teapotlaboratories/petb1a/hardware/kicad/petb1a.kicad_pcb

## KiCad design hardware/kicad/petb1a.kicad_pcb (2024-02-28)

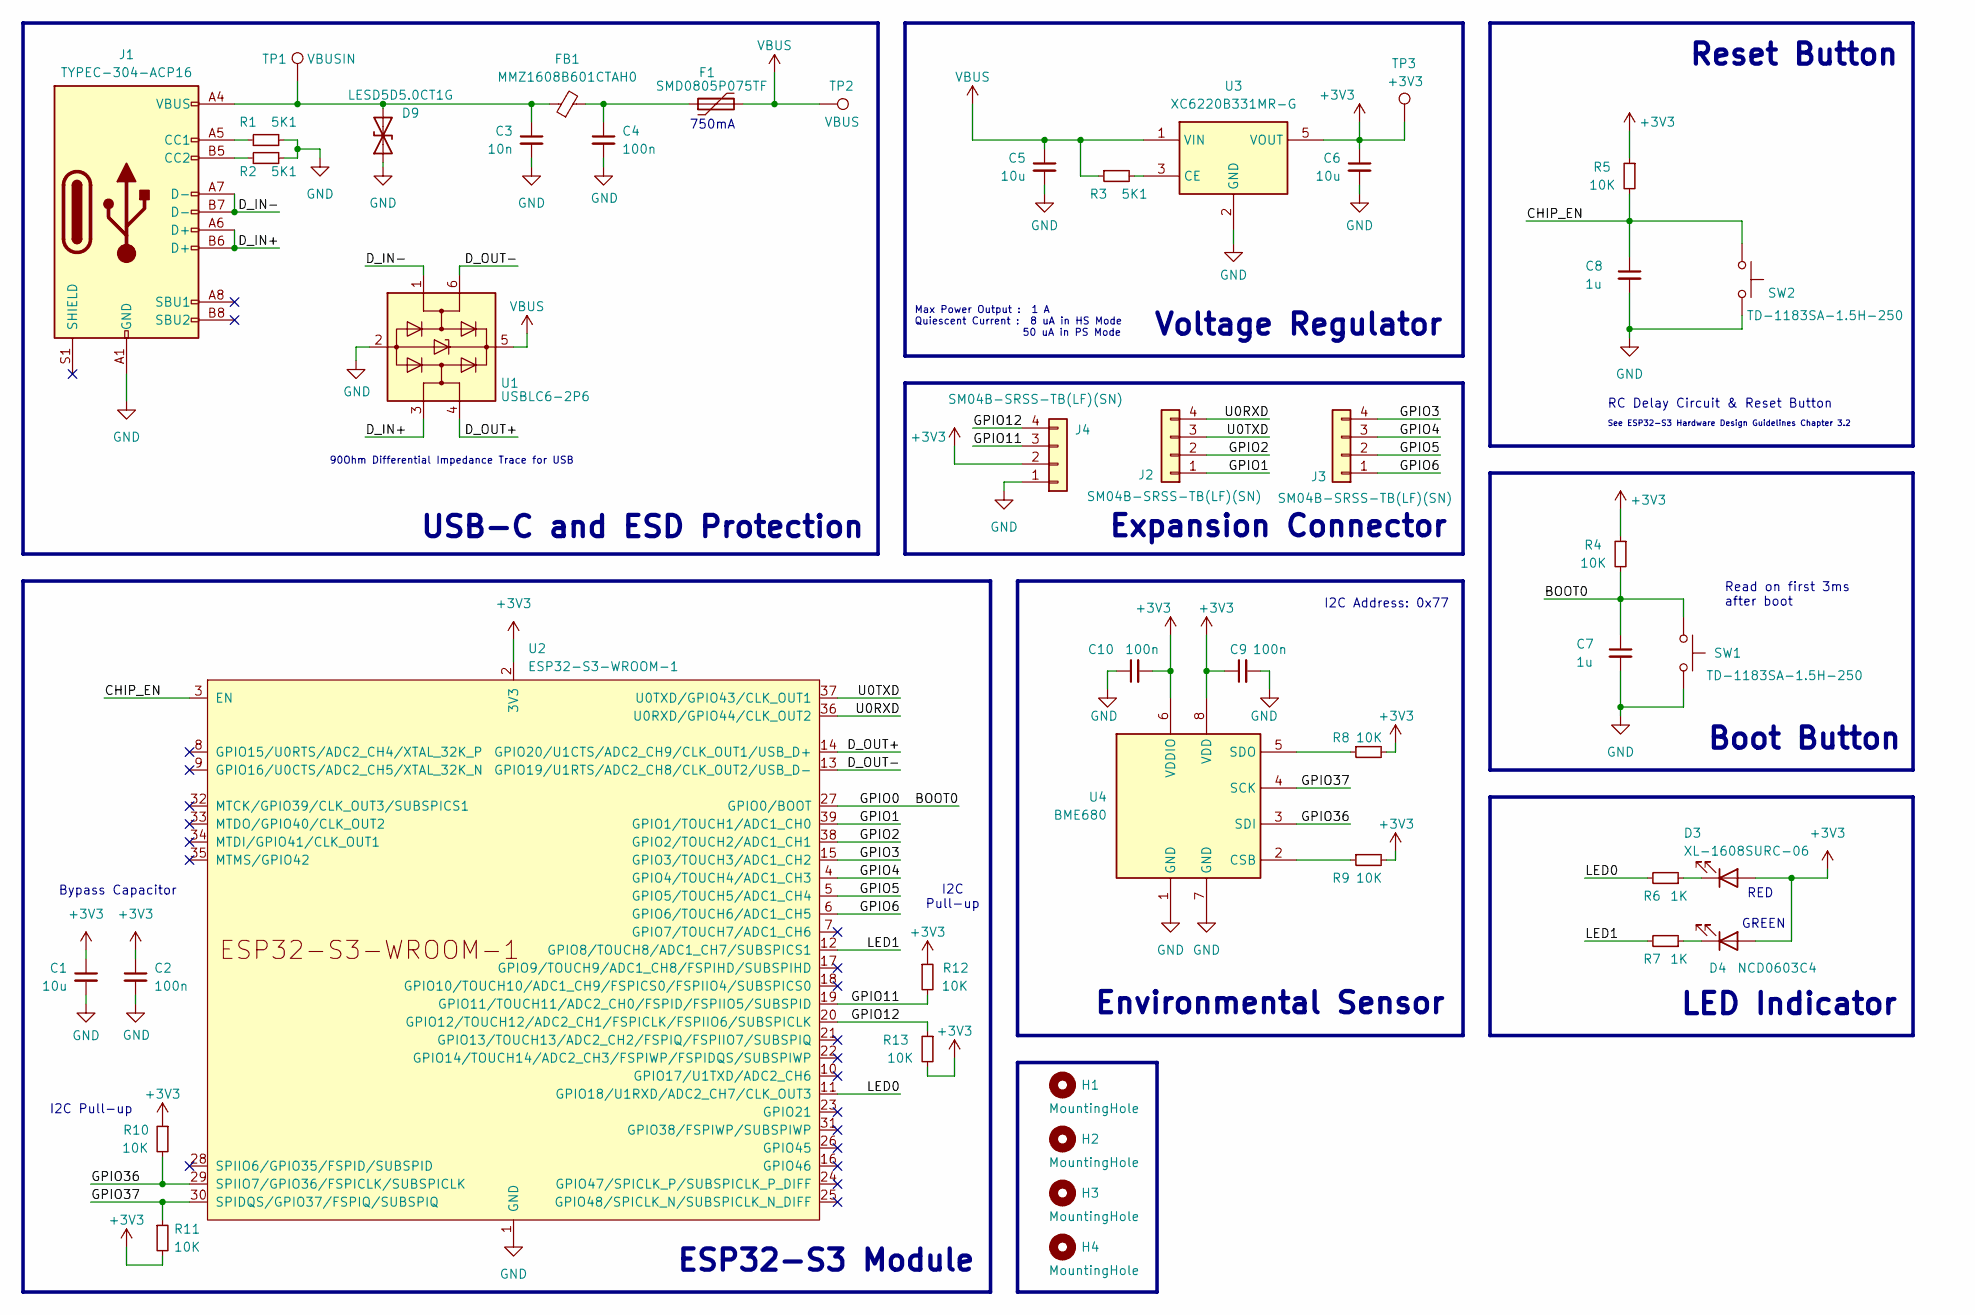
[picture p1: schematic petb1a.kicad_sch, Teapotlabs PETB1A]

Parts:
C1, C5, C6: 10u; C_0603_1608Metric; Manufacturer Part Number CL10A106KP8NNNC
C2, C4: 100n; C_0603_1608Metric; Manufacturer Part Number CL10B104KB8NNNC
C3: 10n; C_0603_1608Metric; Manufacturer Part Number CC0603KRX7R9BB103
C7, C8: 1u; C_0402_1005Metric; Manufacturer Part Number GRM155Z71A105KE01D
C9, C10: 100n; C_0402_1005Metric; Manufacturer Part Number GRM155R71H104KE14D
D3: XL-1608SURC-06; LED_0603_1608Metric; Manufacturer Part Number XL-1608SURC-06
D4: NCD0603C4; LED_0603_1608Metric; Manufacturer Part Number NCD0603C4
D9: LESD5D5.0CT1G; D_SOD-523; Manufacturer Part Number LESD5D5.0CT1G
F1: SMD0805P075TF; Fuse_0805_2012Metric; Manufacturer Part Number SMD0805P075TF
FB1: MMZ1608B601CTAH0; L_0603_1608Metric; Manufacturer Part Number MMZ1608B601CTAH0
H1, H2, H3, H4: MountingHole; MountingHole_3.2mm_M3
J1: TYPEC-304-ACP16; USB-C-SMD_TYPE-C-16P-1; Manufacturer Part Number TYPEC-304-ACP16
J2, J3, J4: SM04B-SRSS-TB(LF)(SN); JST_SH_SM04B-SRSS-TB_1x04-1MP_P1.00mm_Horizontal; Manufacturer Part Number SM04B-SRSS-TB(LF)(SN)
R1, R2, R3: 5K1; R_0402_1005Metric; Manufacturer Part Number 0402WGF5101TCE
R4, R5, R8, R9, R10, R11, R12, R13: 10K; R_0402_1005Metric; Manufacturer Part Number 0402WGF1002TCE
R6, R7: 1K; R_0603_1608Metric; Manufacturer Part Number RC0603FR-071KL
SW1, SW2: TD-1183SA-1.5H-250; KEY-SMD_L3.0-W2.5-LS4.0; Manufacturer Part Number TD-1183SA-1.5H-250
TP1: VBUSIN; TestPoint_Pad_D1.0mm
TP2: VBUS; TestPoint_Pad_D1.0mm
TP3: +3V3; TestPoint_Pad_D1.0mm
U1: USBLC6-2P6; SOT-666; Manufacturer Part Number USBLC6-2P6
U2: ESP32-S3-WROOM-1; Manufacturer Part Number ESP32-S3-WROOM-1-N16R8
U3: XC6220B331MR-G; SOT-23-5; Manufacturer Part Number XC6220B331MR-G
U4: BME680; Bosch_LGA-8_3x3mm_P0.8mm_ClockwisePinNumbering; Manufacturer Part Number BME688

Connections:
+3V3: C1.1, C2.1, C6.1, C9.1, C10.2, D3.2 (A), D4.2 (A), J4.2, R4.1, R5.1, R8.2, R9.2, R10.1, R11.2, R12.1, R13.2, TP3.1, U2.2 (3V3), U3.5 (VOUT), U4.6 (VDDIO), U4.8 (VDD)
/BOOT0: C7.1, R4.2, SW1.2, U2.27 (GPIO0/BOOT)
/CHIP_EN: C8.1, R5.2, SW2.2, U2.3 (EN)
/D_IN+: J1.A6 (D+), J1.B6 (D+), U1.3 (I/O2)
/D_IN-: J1.A7 (D-), J1.B7 (D-), U1.1 (I/O1)
/D_OUT+: U1.4 (I/O2), U2.14 (GPIO20/U1CTS/ADC2_CH9/CLK_OUT1/USB_D+)
/D_OUT-: U1.6 (I/O1), U2.13 (GPIO19/U1RTS/ADC2_CH8/CLK_OUT2/USB_D-)
/GPIO1: J2.1, U2.39 (GPIO1/TOUCH1/ADC1_CH0)
/GPIO2: J2.2, U2.38 (GPIO2/TOUCH2/ADC1_CH1)
/GPIO3: J3.4, U2.15 (GPIO3/TOUCH3/ADC1_CH2)
/GPIO4: J3.3, U2.4 (GPIO4/TOUCH4/ADC1_CH3)
/GPIO5: J3.2, U2.5 (GPIO5/TOUCH5/ADC1_CH4)
/GPIO6: J3.1, U2.6 (GPIO6/TOUCH6/ADC1_CH5)
/GPIO11: J4.3, R12.2, U2.19 (GPIO11/TOUCH11/ADC2_CH0/FSPID/FSPIIO5/S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)
/GPIO12: J4.4, R13.1, U2.20 (GPIO12/TOUCH12/ADC2_CH1/FSPICLK/FSPIIO6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)
/GPIO36: R10.2, U2.29 (SPIIO7/GPIO36/FSPICLK/SUBSPICLK), U4.3 (SDI)
/GPIO37: R11.1, U2.30 (SPIDQS/GPIO37/FSPIQ/SUBSPIQ), U4.4 (SCK)
/LED0: R6.2, U2.11 (GPIO18/U1RXD/ADC2_CH7/CLK_OUT3)
/LED1: R7.2, U2.12 (GPIO8/TOUCH8/ADC1_CH7/SUBSPICS1)
/U0RXD: J2.4, U2.36 (U0RXD/GPIO44/CLK_OUT2)
/U0TXD: J2.3, U2.37 (U0TXD/GPIO43/CLK_OUT1)
GND: C1.2, C2.2, C3.2, C4.2, C5.2, C6.2, C7.2, C8.2, C9.2, C10.1, J1.A1 (GND), J1.A12 (GND), J1.B1 (GND), J1.B12 (GND), J4.1, R1.2, R2.2, SW1.1, SW2.1, U1.2 (GND), U2.1 (GND), U2.40 (GND), U2.41 (GND), U3.2 (GND), U4.1 (GND), U4.7 (GND); also elsewhere on the board
unnamed: C4.1, F1.1, FB1.2
unnamed 23: C3.1, FB1.1, J1.A4 (VBUS), J1.A9 (VBUS), J1.B4 (VBUS), J1.B9 (VBUS), TP1.1; also elsewhere on the board
unnamed: D3.1 (K), R6.1
unnamed: D4.1 (K), R7.1
unnamed: J1.A5 (CC1), R1.1
unnamed: J1.B5 (CC2), R2.1
unnamed: R3.2, U3.3 (CE)
unnamed: R9.1, U4.2 (CSB)
unnamed: R8.1, U4.5 (SDO)
VBUS: C5.1, F1.2, R3.1, TP2.1, U1.5 (VBUS), U3.1 (VIN)

Notes on the sheet:
LED Indicator
Expansion Connector
Max Power Output : 1 A Quiescent Current : 8 uA in HS Mode 50 uA in PS Mode
RC Delay Circuit & Reset Button
I2C Pull-up
Environmental Sensor
RED
Boot Button
Reset Button
90Ohm Differential Impedance Trace for USB
Bypass Capacitor
I2C Address: 0x77
USB-C and ESD Protection
Voltage Regulator
I2C Pull-up
ESP32-S3 Module
Read on first 3ms after boot
See ESP32-S3 Hardware Design Guidelines Chapter 3.2
750mA
GREEN

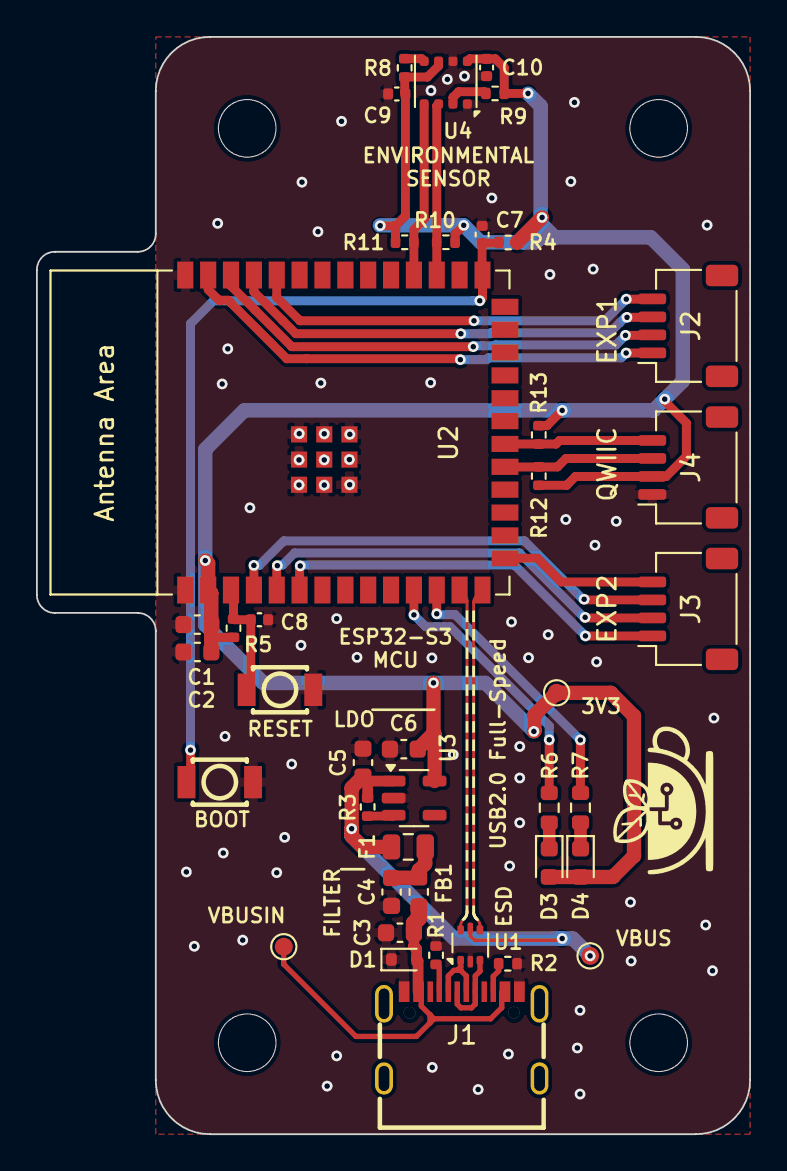
[picture p2: board petb1a.kicad_pcb from above]

Board: 4 copper layers, 39.6 x 61.0 mm, 45 parts (0 on the bottom side), 32 nets.

Other parts of the board:
D1: LESD5D5.0CT1G; D_SOD-523

Their connections:
GND: D1.1 (A1); also elsewhere on the board
unnamed 23: D1.2 (A2); also elsewhere on the board
