teapotlaboratories/petb1a/(commit log)

2024-02-19 initial kicad file
    [petb1a.kicad_pcb, petb1a.kicad_sch]
2024-02-19 add usb-c and filter
    [petb1a.kicad_sch]
2024-02-20 add reset, boot, ldo and bypass cap
    [petb1a.kicad_sch]
2024-02-21 update schematic
    [petb1a.kicad_sch]
2024-02-22 update schematics
    [petb1a.kicad_sch]
2024-02-22 change socket to header
    [petb1a.kicad_sch]
2024-02-23 intial pcb wiring
    [petb1a.kicad_pcb, petb1a.kicad_sch]
2024-02-23 update pcb layout
    [petb1a.kicad_pcb, petb1a.kicad_sch]
2024-02-24 update pcb
    [petb1a.kicad_pcb, petb1a.kicad_sch]
2024-02-27 update board
    [petb1a.kicad_pcb, petb1a.kicad_sch]
2024-02-28 revision 1 design
    [TeapotlabsPETB1A_BOM.csv, petb1a.kicad_pcb, petb1a.kicad_sch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]
